onionsat-pcbs/gaia-muon/3d/KEY-SMD_L4.0-W3.0-LS4.9.step

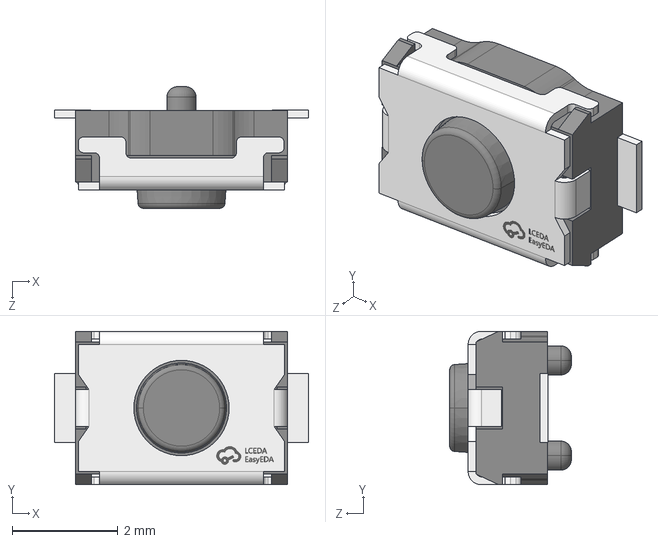
[picture p1: CAD file, 2026-01-07]
3d/KEY-SMD_L4.0-W3.0-LS4.9.step
4.80 x 2.90 x 2.30 mm
