onionsat-pcbs/gaia-muon/3d/HDR2.00-F-LS-2X10P.step

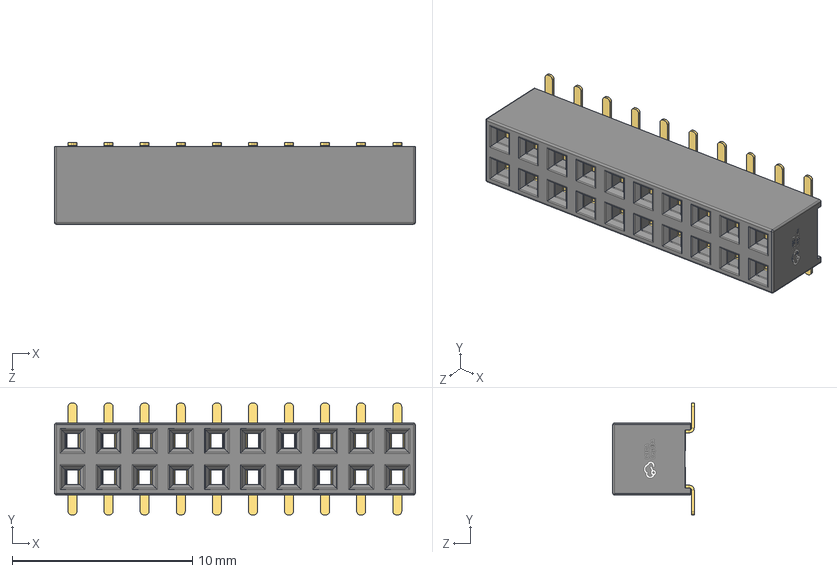
[picture p2: CAD file, 2026-01-07]
3d/HDR2.00-F-LS-2X10P.step
20.0 x 6.20 x 4.52 mm
