onionsat-pcbs/gaia-muon/3d/scintillatorholder.step

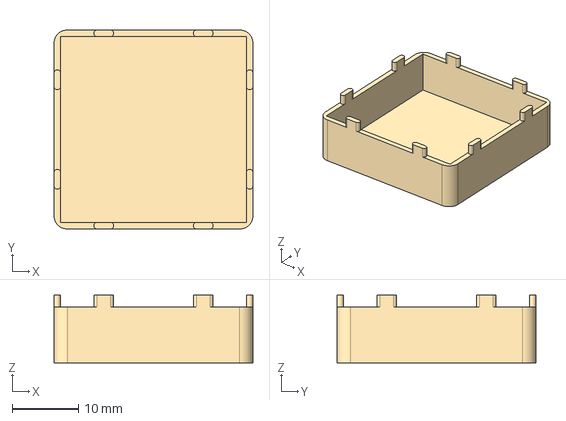
[picture p3: CAD file, 2026-01-07]
3d/scintillatorholder.step
30.0 x 30.0 x 10.2 mm
