onionsat-pcbs/gaia-muon/schematics/gaia-muon_schemativ_rev1.0.pdf

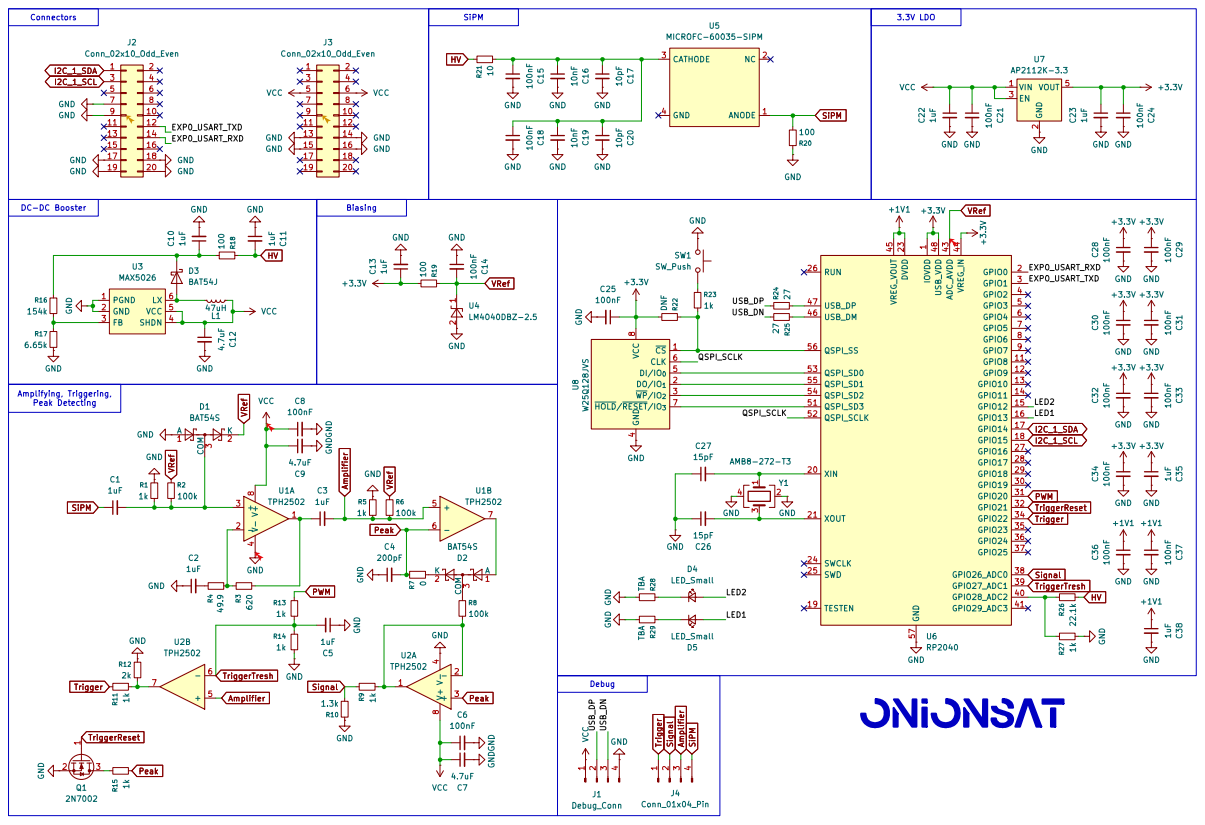
[picture p4: page 1]
