onionsat-pcbs/gaia-muon/gaia-muon.kicad_pcb

## KiCad design gaia-muon.kicad_pcb (2026-01-07)

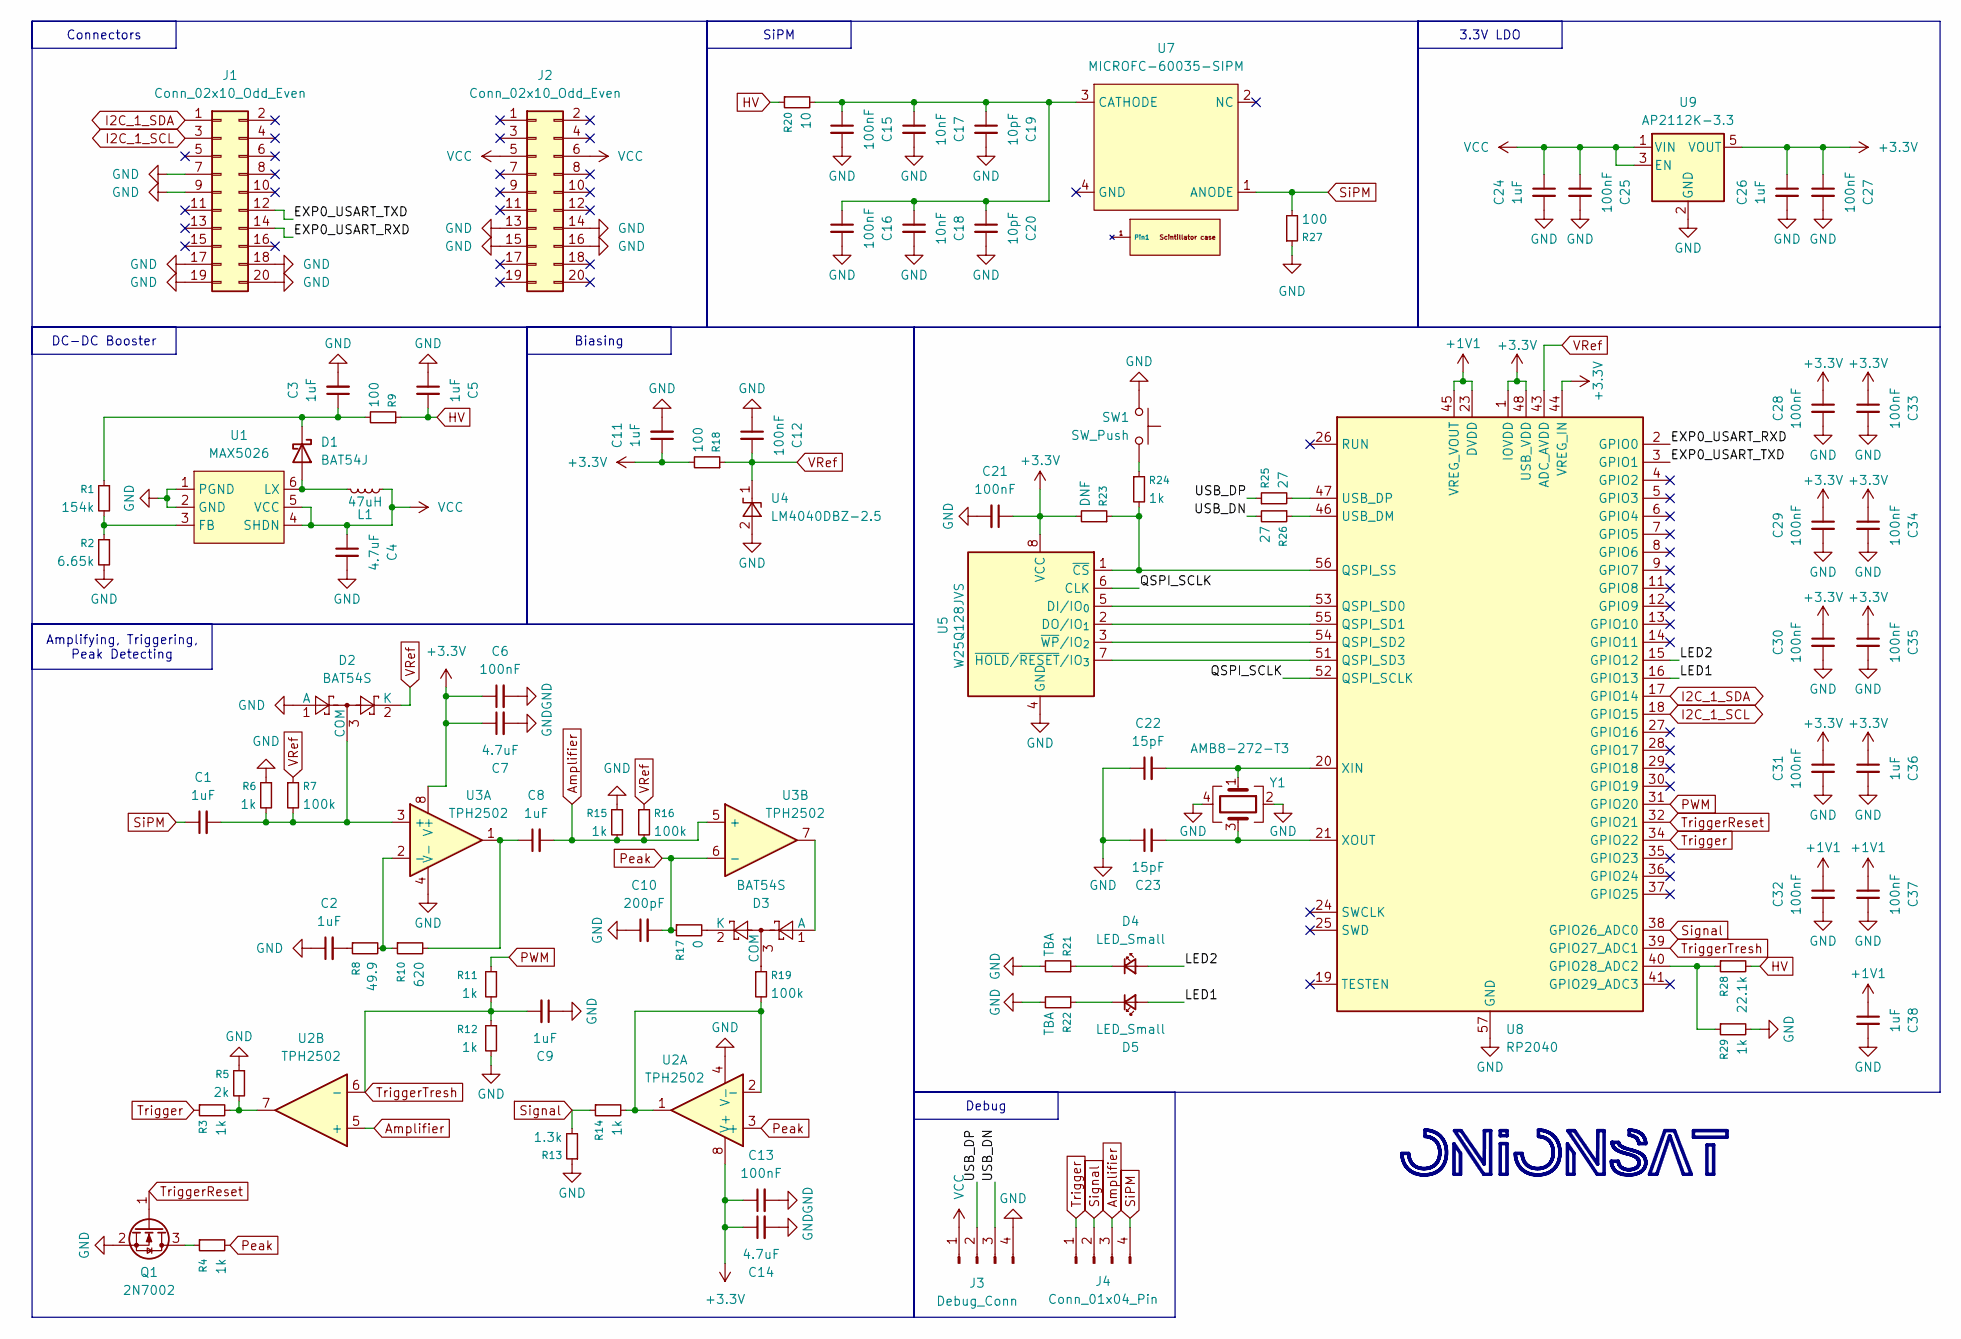
[picture p5: schematic gaia-muon.kicad_sch, GAIA Muon Detector]

Parts:
C1, C2, C3, C5, C8, C9, C11: 1uF; C_0805_2012Metric
C4: 4.7uF; C_0805_2012Metric
C6, C13, C28, C29, C30, C31, C32, C33, C34, C35, C37: 100nF; C_0402_1005Metric
C7, C14: 4.7uF; C_0402_1005Metric
C10: 200pF; C_0805_2012Metric
C12, C15, C16, C21: 100nF; C_0805_2012Metric
C17, C18: 10nF; C_0805_2012Metric
C19, C20: 10pF; C_0805_2012Metric
C22, C23: 15pF; C_0402_1005Metric
C24, C26: 1uF; C_0603_1608Metric
C25, C27: 100nF; C_0603_1608Metric
C36, C38: 1uF; C_0402_1005Metric
D1: BAT54J; D_SOD-323F
D2, D3: BAT54S; SOT-23
D4, D5: LED_Small; LED_0603_1608Metric
J1, J2: Conn_02x10_Odd_Even; Gaia_connector_2_4layer
J3: Debug_Conn; PinHeader_1x04_P2.54mm_Vertical
J4: Conn_01x04_Pin; PinHeader_1x04_P2.54mm_Vertical
L1: 47uH; L_0805_2012Metric
Q1: 2N7002; SOT-23
R1: 154k; R_0603_1608Metric
R2: 6.65k; R_0603_1608Metric
R3, R4, R6, R11, R12, R14, R15, R29: 1k; R_0805_2012Metric
R5: 2k; R_0805_2012Metric
R7, R16, R19: 100k; R_0805_2012Metric
R8: 49.9; R_0805_2012Metric
R9, R18, R27: 100; R_0805_2012Metric
R10: 620; R_0805_2012Metric
R13: 1.3k; R_0805_2012Metric
R17: 0; R_0805_2012Metric
R20: 10; R_0805_2012Metric
R21, R22: TBA; R_0402_1005Metric
R23: DNF; R_0402_1005Metric
R24: 1k; R_0402_1005Metric
R25, R26: 27; R_0402_1005Metric
R28: 22.1k; R_0805_2012Metric
SW1: SW_Push; KEY-SMD_L4.0-W3.0-LS4.9-1
U1: MAX5026; SOT-23-6
U2, U3: TPH2502; MSOP-8_3x3mm_P0.65mm
U4: LM4040DBZ-2.5; SOT-23
U5: W25Q128JVS; SOIC-8_5.3x5.3mm_P1.27mm
U6: scintillator-case
U7: MICROFC-60035-SIPM
U8: RP2040; QFN-56-1EP_7x7mm_P0.4mm_EP3.2x3.2mm
U9: AP2112K-3.3; SOT-23-5
Y1: AMB8-272-T3; Crystal_SMD_3225-4Pin_3.2x2.5mm

Connections:
+1V1: C32.1, C37.1, C38.1, U8.23 (DVDD), U8.45 (VREG_VOUT), U8.50 (DVDD)
+3.3V: C6.1, C7.1, C11.1, C13.1, C14.1, C21.1, C26.1, C27.1, C28.1, C29.1, C30.1, C31.1, C33.1, C34.1, C35.1, C36.1, R18.2, R23.2, U2.8 (V+), U3.8 (V+), U5.8 (VCC), U8.1 (IOVDD), U8.10 (IOVDD), U8.22 (IOVDD), U8.33 (IOVDD), U8.42 (IOVDD), U8.44 (VREG_IN), U8.48 (USB_VDD), U8.49 (IOVDD), U9.5 (VOUT)
/EXP0_USART_RXD: J1.14, U8.2 (GPIO0)
/EXP0_USART_TXD: J1.12, U8.3 (GPIO1)
/LED1: D5.2 (A), U8.16 (GPIO13)
/LED2: D4.2 (A), U8.15 (GPIO12)
/QSPI_SCLK: U5.6 (CLK), U8.52 (QSPI_SCLK)
/USB_DN: J3.3, R26.2
/USB_DP: J3.2, R25.1
Amplifier: C8.2, J4.3, R15.2, R16.2, U2.5 (+), U3.5 (+)
GND: C2.1, C3.2, C4.2, C5.1, C6.2, C7.2, C9.1, C10.1, C11.2, C12.1, C13.2, C14.2, C15.2, C16.2, C17.2, C18.2, C19.2, C20.2, C21.2, C22.1, C23.1, C24.2, C25.2, C26.2, C27.2, C28.2, C29.2, C30.2, C31.2, C32.2, C33.2, C34.2, C35.2, C36.2, C37.2, C38.2, D2.1 (A), J1.7, J1.9, J1.17, J1.18, J1.19, J1.20, J2.13, J2.14, J2.15, J2.16, J3.4, Q1.2 (S), R2.2, R5.1, R6.1, R12.2, R13.1, R15.1, R21.2, R22.2, R27.1, R29.2, SW1.2, U1.1 (PGND), U1.2 (GND), U2.4 (V-), U3.4 (V-), U4.2 (A), U5.4 (GND), U8.57 (GND), U9.2 (GND), Y1.2, Y1.4
HV: C5.2, R9.1, R20.1, R28.2
I2C_1_SCL: J1.3, U8.18 (GPIO15)
I2C_1_SDA: J1.1, U8.17 (GPIO14)
unnamed: C2.2, R8.1
unnamed: C8.1, R10.2, U3.1
unnamed: D1.2 (A), L1.1, U1.6 (LX)
unnamed: C3.1, D1.1 (K), R1.1, R9.2
unnamed: C1.2, D2.3 (COM), R6.2, R7.2, U3.3 (+)
unnamed: D3.1 (A), U3.7
unnamed: D3.3 (COM), R19.1
unnamed: D3.2 (K), R17.2
unnamed: D4.1 (K), R21.1
unnamed: D5.1 (K), R22.1
unnamed: Q1.3 (D), R4.1
unnamed: R3.2, R5.2, U2.7
unnamed: R24.1, SW1.1
unnamed: R1.2, R2.1, U1.3 (FB)
unnamed: R14.2, R19.2, U2.1, U2.2 (-)
unnamed: R8.2, R10.1, U3.2 (-)
unnamed: U5.5 (DI/IO_{0}), U8.53 (QSPI_SD0)
unnamed: U5.2 (DO/IO_{1}), U8.55 (QSPI_SD1)
unnamed: R23.1, R24.2, U5.1 (~CS), U8.56 (QSPI_SS)
unnamed: U5.7 (~HOLD/~RESET/IO_{3}), U8.51 (QSPI_SD3)
unnamed: U5.3 (~WP/IO_{2}), U8.54 (QSPI_SD2)
unnamed: C15.1, C16.1, C17.1, C18.1, C19.1, C20.1, R20.2, U7.3 (CATHODE)
unnamed: R28.1, R29.1, U8.40 (GPIO28_ADC2)
unnamed: R26.1, U8.46 (USB_DM)
unnamed: R25.2, U8.47 (USB_DP)
unnamed: C22.2, U8.20 (XIN), Y1.1
unnamed: C23.2, U8.21 (XOUT), Y1.3
PWM: R11.1, U8.31 (GPIO20)
Peak: C10.2, R4.2, R17.1, U2.3 (+), U3.6 (-)
SiPM: C1.1, J4.4, R27.2, U7.1 (ANODE)
Signal: J4.2, R13.2, R14.1, U8.38 (GPIO26_ADC0)
Trigger: J4.1, R3.1, U8.34 (GPIO22)
TriggerReset: Q1.1 (G), U8.32 (GPIO21)
TriggerTresh: C9.2, R11.2, R12.1, U2.6 (-), U8.39 (GPIO27_ADC1)
VCC: C4.1, C24.1, C25.1, J2.5, J2.6, J3.1, L1.2, U1.4 (SHDN), U1.5 (VCC), U9.1 (VIN), U9.3 (EN)
VRef: C12.2, D2.2 (K), R7.1, R16.1, R18.1, U4.1 (K), U8.43 (ADC_AVDD)

Notes on the sheet:
SiPM
3.3V LDO
Biasing
Connectors
Debug
Amplifying, Triggering, Peak Detecting
DC-DC Booster

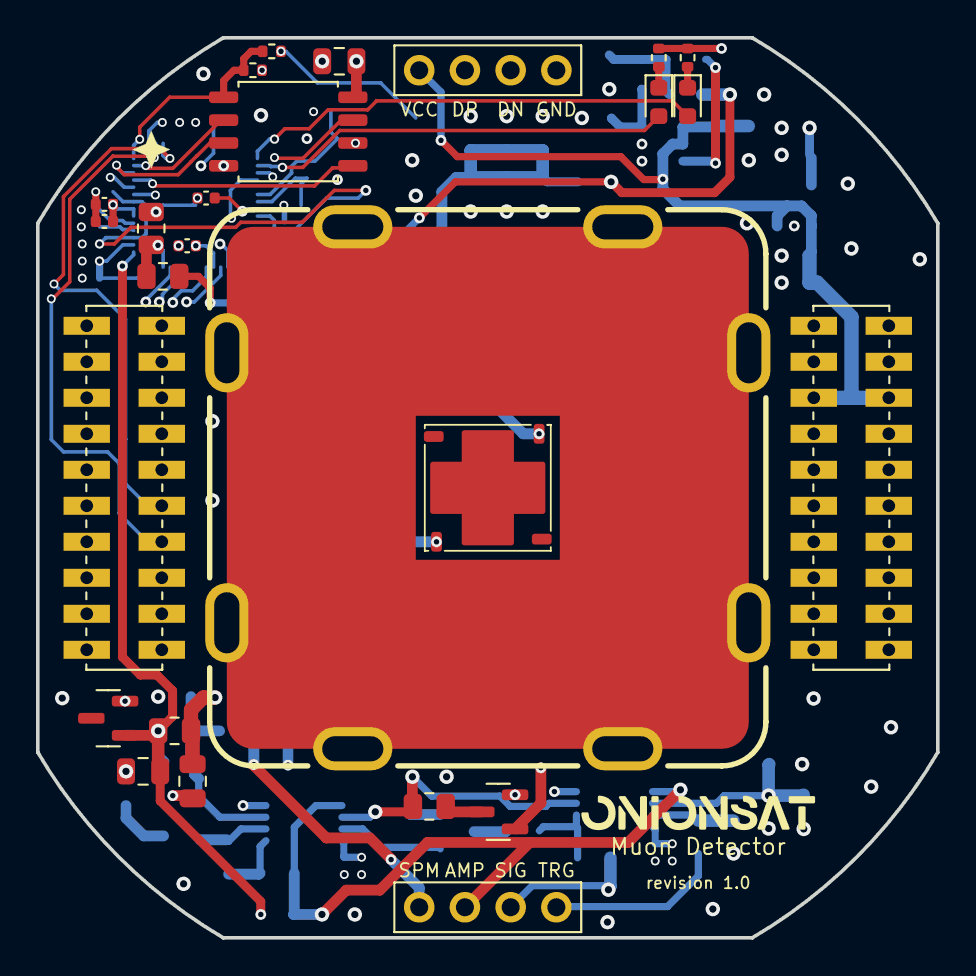
[picture p6: board gaia-muon.kicad_pcb from above]

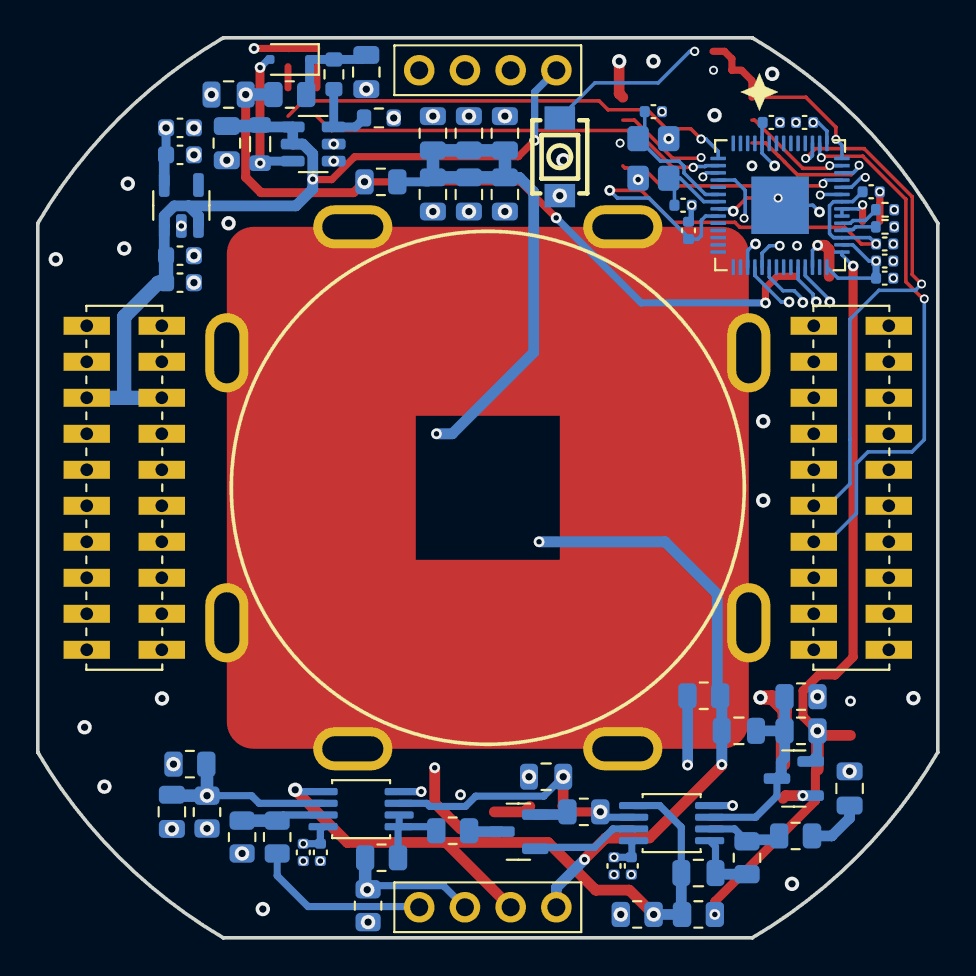
[picture p7: board gaia-muon.kicad_pcb from below]

Board: 6 copper layers, 50.0 x 50.0 mm, 89 parts (65 on the bottom side), 50 nets.
