onionsat-pcbs/gaia-muon/(commit log)

2025-10-12 creating schematic
    [gaia-muon.kicad_pcb, gaia-muon.kicad_sch]
2025-10-13 scintillator case update
2025-10-14 placing components, start routing
    [gaia-muon.kicad_pcb, gaia-muon.kicad_sch]
2025-10-15 finish routing
    [gaia-muon.kicad_pcb]
2025-10-15 fix routing
    [gaia-muon.kicad_pcb]
2025-10-15 silkscreen cleanup
    [gaia-muon.kicad_sch]
2025-10-15 removing 2 layers (8->6 layers)
    [gaia-muon.kicad_pcb]
2025-10-15 generating production file for JLC review
    [gaia-muon-3V3.gbr, gaia-muon-B_Cu.gbr, gaia-muon-B_Mask.gbr, gaia-muon-B_Paste.gbr, gaia-muon-B_Silkscreen.gbr, gaia-muon-Edge_Cuts.gbr, gaia-muon-F_Cu.gbr, gaia-muon-F_Mask.gbr]
2025-10-16 Production start
    [gaia-muon-3V3.gbr, gaia-muon-B_Cu.gbr, gaia-muon-B_Mask.gbr, gaia-muon-B_Paste.gbr, gaia-muon-B_Silkscreen.gbr, gaia-muon-Edge_Cuts.gbr, gaia-muon-F_Cu.gbr, gaia-muon-F_Mask.gbr]
2025-10-16 adding stitching vias
    [gaia-muon-3V3.gbr, gaia-muon-B_Cu.gbr, gaia-muon-B_Mask.gbr, gaia-muon-B_Paste.gbr, gaia-muon-B_Silkscreen.gbr, gaia-muon-Edge_Cuts.gbr, gaia-muon-F_Cu.gbr, gaia-muon-F_Mask.gbr]
2026-01-07 fixing 3d models
    [HDR2.00-F-LS-2X10P.step, KEY-SMD_L4.0-W3.0-LS4.9.step, gaia-muon.kicad_pcb, scintillatorholder.step]
